Nolven/SAD_glasses/hardware/output/SAD/sad_bom.csv

Manufacturer Part Number | Manufacturer | Description | References | Qty per board | Order Qty
LP5012RUKR | Texas Instruments | 12-ch I2C LED driver WQFN-20 3x3 | IC1 | 1 | 3
ATTINY1616-MNR | Microchip | AVR MCU 16KB VQFN-20 3x3 | U1 | 1 | 3
MCP73831T-2ACI/OT | Microchip | Li-ion charger 4.20V SOT-23-5 | U2 | 1 | 3
TPD1E10B06DPYR | Texas Instruments | ESD TVS 5.5V bidirectional 0402 X1SON (SOD-882 size) | D1, D2 | 2 | 6
EVQ-P7A01P | Panasonic | Side-push tact switch 3.5x2.9mm 2.2N | S1, S2 | 2 | 6
USB4105-GF-A | GCT | USB-C 2.0 16P top-mount receptacle 0.95mm stakes | J1 | 1 | 3
L1C1-CYN1000000000 | Lumileds | LUXEON C Cyan 490-510nm 2x2mm | LED pads | 12 | 15
CL05A105KP5NNNC | Samsung Electro-Mechanics | 1uF 10V X5R 0402 (alt: TDK C1005X5R1A105K050BC) | C1, C5 | 2 | 10
GRM155R71C104KA88D | Murata | 100nF 16V X7R 0402 | C2 | 1 | 10
GRM155R71H103KA88D | Murata | 10nF 50V X7R 0402 | C3, C4 | 2 | 10
CL10A475KO8NNNC | Samsung Electro-Mechanics | 4.7uF 16V X5R 0603 (alt: TDK C1608X5R1C475K080AC) | C6, C7, C8 (+ anode bulk cap) | 4 | 15
RC0402FR-072K94L | Yageo | 2.94k 1% 0402 | R1 | 1 | 10
RC0402FR-07100KL | Yageo | 100k 1% 0402 | R2 | 1 | 10
RC0402FR-076K8L | Yageo | 6.8k 1% 0402 | R3 | 1 | 10
RC0402FR-074K7L | Yageo | 4.7k 1% 0402 | R4, R10, R11 | 3 | 10
RC0402FR-071ML | Yageo | 1M 1% 0402 | R5 | 1 | 10
RC0402FR-075K1L | Yageo | 5.1k 1% 0402 | R6, R7 | 2 | 10
RC0402FR-071KL | Yageo | 1k 1% 0402 | R8, R9, R12 | 3 | 10
