Nolven/SAD_glasses/hardware/LED_platform/LED_platform.kicad_pcb

## KiCad design hardware/LED_platform/LED_platform.kicad_pcb (2026-10-20)

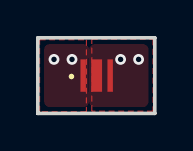
[picture p1: board LED_platform.kicad_pcb from above]

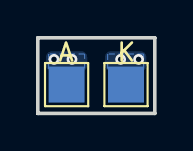
[picture p2: board LED_platform.kicad_pcb from below]

Board: 2 copper layers, 6.5 x 4.2 mm, 3 parts (2 on the bottom side), 2 nets, no tracks yet.

Parts:
A: A; TestPoint_Pad_2.0x2.0mm
K: K; TestPoint_Pad_2.0x2.0mm
LED1: L1C1-CYN1000000000; L1C1CYN1000000000

Connections:
unnamed: A.1 (1_1), LED1.2 (A), LED1.3 (HEAT_PAD)
unnamed: K.1 (1_1), LED1.1 (K)
