Nolven/SAD_glasses/hardware/sad/sad.kicad_pcb

## KiCad design hardware/sad/sad.kicad_pcb (2026-10-15)

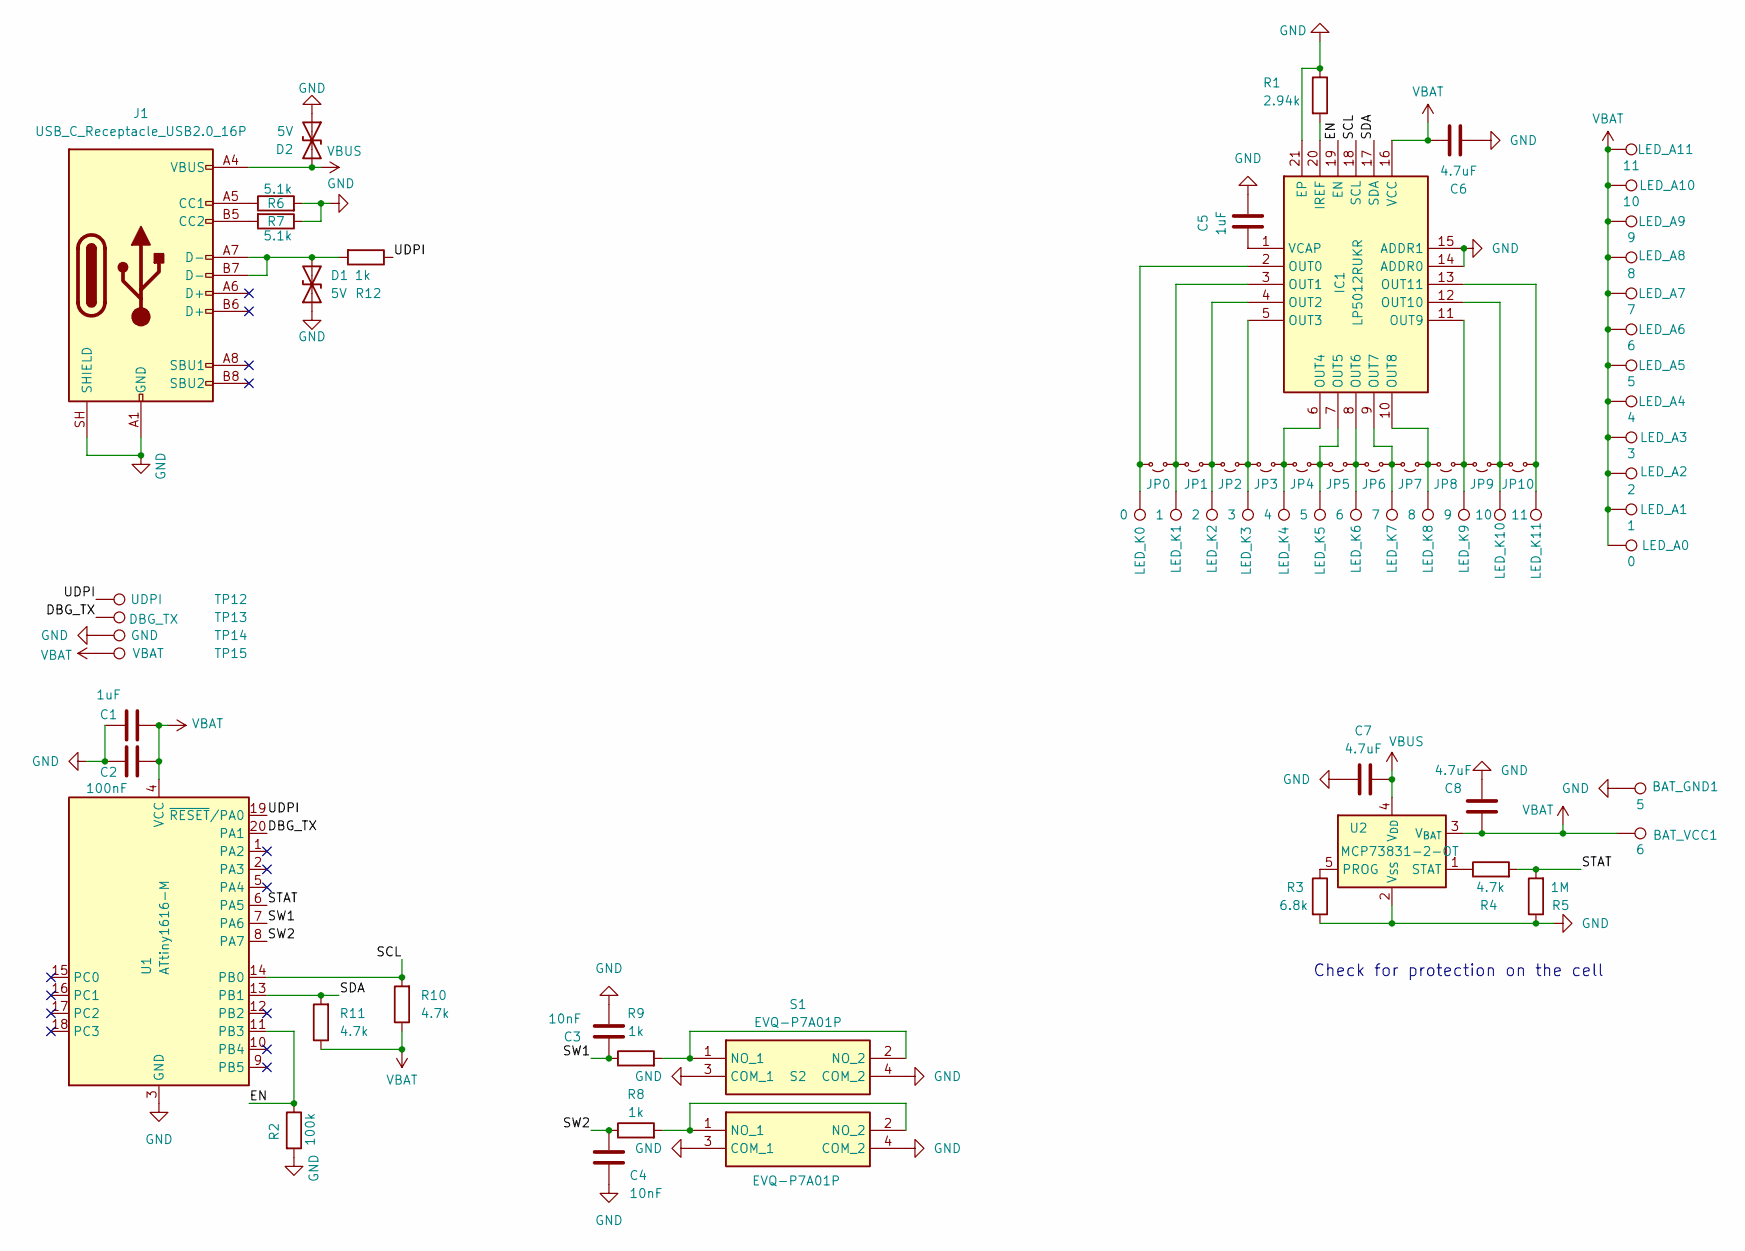
[picture p3: schematic sad.kicad_sch]

Parts:
BAT_GND1: 5; SolderWirePad_1x01_SMD_1x2mm
BAT_VCC1: 6; SolderWirePad_1x01_SMD_1x2mm
C1, C5: 1uF; C_0402_1005Metric_Pad0.74x0.62mm_HandSolder
C2: 100nF; C_0402_1005Metric_Pad0.74x0.62mm_HandSolder
C3, C4: 10nF; C_0402_1005Metric_Pad0.74x0.62mm_HandSolder
C6, C7, C8: 4.7uF; C_0603_1608Metric_Pad1.08x0.95mm_HandSolder
D1, D2: 5V; D_SOD-882
IC1: LP5012RUKR; QFN40P300X300X80-21N-D; Manufacturer_Part_Number LP5012RUKR; Mouser Part Number 595-LP5012RUKR
J1: USB_C_Receptacle_USB2.0_16P; USB_C_Receptacle_GCT_USB4105-xx-A_16P_TopMnt_Horizontal
JP0, JP1, JP2, JP3, JP4, JP5, JP6, JP7, JP8, JP9, JP10: R_0402_1005Metric_Pad0.72x0.64mm_HandSolder
LED_A0: 0; SolderWirePad_1x01_SMD_1x2mm
LED_A1: 1; SolderWirePad_1x01_SMD_1x2mm
LED_A2: 2; SolderWirePad_1x01_SMD_1x2mm
LED_A3: 3; SolderWirePad_1x01_SMD_1x2mm
LED_A4: 4; SolderWirePad_1x01_SMD_1x2mm
LED_A5: 5; SolderWirePad_1x01_SMD_1x2mm
LED_A6: 6; SolderWirePad_1x01_SMD_1x2mm
LED_A7: 7; SolderWirePad_1x01_SMD_1x2mm
LED_A8: 8; SolderWirePad_1x01_SMD_1x2mm
LED_A9: 9; SolderWirePad_1x01_SMD_1x2mm
LED_A10: 10; SolderWirePad_1x01_SMD_1x2mm
LED_A11: 11; SolderWirePad_1x01_SMD_1x2mm
LED_K0: 0; SolderWirePad_1x01_SMD_1x2mm
LED_K1: 1; SolderWirePad_1x01_SMD_1x2mm
LED_K2: 2; SolderWirePad_1x01_SMD_1x2mm
LED_K3: 3; SolderWirePad_1x01_SMD_1x2mm
LED_K4: 4; SolderWirePad_1x01_SMD_1x2mm
LED_K5: 5; SolderWirePad_1x01_SMD_1x2mm
LED_K6: 6; SolderWirePad_1x01_SMD_1x2mm
LED_K7: 7; SolderWirePad_1x01_SMD_1x2mm
LED_K8: 8; SolderWirePad_1x01_SMD_1x2mm
LED_K9: 9; SolderWirePad_1x01_SMD_1x2mm
LED_K10: 10; SolderWirePad_1x01_SMD_1x2mm
LED_K11: 11; SolderWirePad_1x01_SMD_1x2mm
R1: 2.94k; R_0402_1005Metric_Pad0.72x0.64mm_HandSolder
R2: 100k; R_0402_1005Metric_Pad0.72x0.64mm_HandSolder
R3: 6.8k; R_0402_1005Metric_Pad0.72x0.64mm_HandSolder
R4, R10, R11: 4.7k; R_0402_1005Metric_Pad0.72x0.64mm_HandSolder
R5: 1M; R_0402_1005Metric_Pad0.72x0.64mm_HandSolder
R6, R7: 5.1k; R_0402_1005Metric_Pad0.72x0.64mm_HandSolder
R8, R9, R12: 1k; R_0402_1005Metric_Pad0.72x0.64mm_HandSolder
S1, S2: EVQ-P7A01P; EVQP7J01P; Manufacturer_Part_Number EVQ-P7A01P; Mouser Part Number 667-EVQP7A01P
TP12: UDPI; SolderWirePad_1x01_SMD_1x2mm
TP13: DBG_TX; SolderWirePad_1x01_SMD_1x2mm
TP14: GND; SolderWirePad_1x01_SMD_1x2mm
TP15: VBAT; SolderWirePad_1x01_SMD_1x2mm
U1: ATtiny1616-M; VQFN-20-1EP_3x3mm_P0.4mm_EP1.7x1.7mm
U2: MCP73831-2-OT; SOT-23-5

Connections:
/DBG_TX: TP13.1, U1.20 (PA1); also elsewhere on the board
/EN: IC1.19 (EN), R2.1, U1.11 (PB3)
/SCL: IC1.18 (SCL), R10.2, U1.14 (PB0)
/SDA: IC1.17 (SDA), R11.2, U1.13 (PB1)
/STAT: R4.2, R5.2, U1.6 (PA5)
/SW1: C3.1, R9.1, U1.7 (PA6)
/SW2: C4.1, R8.1, U1.8 (PA7)
/UDPI: R12.1, TP12.1, U1.19 (~RESET/PA0); also elsewhere on the board
GND: BAT_GND1.1, C1.2, C2.1, C3.2, C4.2, C5.2, C6.1, C7.1, C8.2, D1.1 (A1), D2.1 (A1), IC1.14 (ADDR0), IC1.15 (ADDR1), IC1.21 (EP), J1.A1 (GND), J1.A12 (GND), J1.B1 (GND), J1.B12 (GND), J1.SH (SHIELD), R1.1, R2.2, R3.2, R5.1, R6.2, R7.1, S1.3 (COM_1), S1.4 (COM_2), S2.3 (COM_1), S2.4 (COM_2), TP14.1, U1.3 (GND), U1.21 (GND), U2.2 (V_{SS}); also elsewhere on the board
unnamed: D1.2 (A2), J1.A7 (D-), J1.B7 (D-), R12.2
unnamed: IC1.20 (IREF), R1.2
unnamed: IC1.2 (OUT0), JP0.2 (B), LED_K0.1 (1_1)
unnamed: IC1.3 (OUT1), JP0.1 (A), JP1.2 (B), LED_K1.1 (1_1)
unnamed: IC1.4 (OUT2), JP1.1 (A), JP2.1 (A), LED_K2.1 (1_1)
unnamed: IC1.5 (OUT3), JP2.2 (B), JP3.2 (B), LED_K3.1 (1_1)
unnamed: IC1.6 (OUT4), JP3.1 (A), JP4.2 (B), LED_K4.1 (1_1)
unnamed: IC1.7 (OUT5), JP4.1 (A), JP5.2 (B), LED_K5.1 (1_1)
unnamed: IC1.8 (OUT6), JP5.1 (A), JP6.2 (B), LED_K6.1 (1_1)
unnamed: IC1.9 (OUT7), JP6.1 (A), JP7.2 (B), LED_K7.1 (1_1)
unnamed: IC1.10 (OUT8), JP7.1 (A), JP8.2 (B), LED_K8.1 (1_1)
unnamed: IC1.11 (OUT9), JP8.1 (A), JP9.2 (B), LED_K9.1 (1_1)
unnamed: IC1.12 (OUT10), JP9.1 (A), JP10.2 (B), LED_K10.1 (1_1)
unnamed: IC1.13 (OUT11), JP10.1 (A), LED_K11.1 (1_1)
unnamed: C5.1, IC1.1 (VCAP)
unnamed: J1.A5 (CC1), R6.1
unnamed: J1.B5 (CC2), R7.2
unnamed: R9.2, S1.1 (NO_1), S1.2 (NO_2)
unnamed: R8.2, S2.1 (NO_1), S2.2 (NO_2)
unnamed: R3.1, U2.5 (PROG)
unnamed: R4.1, U2.1 (STAT)
VBAT: BAT_VCC1.1, C1.1, C2.2, C6.2, C8.1, IC1.16 (VCC), LED_A0.1 (1_1), LED_A1.1 (1_1), LED_A2.1 (1_1), LED_A3.1 (1_1), LED_A4.1 (1_1), LED_A5.1 (1_1), LED_A6.1 (1_1), LED_A7.1 (1_1), LED_A8.1 (1_1), LED_A9.1 (1_1), LED_A10.1 (1_1), LED_A11.1 (1_1), R10.1, R11.1, TP15.1, U1.4 (VCC), U2.3 (V_{BAT}); also elsewhere on the board
VBUS: C7.2, D2.2 (A2), J1.A4 (VBUS), J1.A9 (VBUS), J1.B4 (VBUS), J1.B9 (VBUS), U2.4 (V_{DD})

Notes on the sheet:
Check for protection on the cell

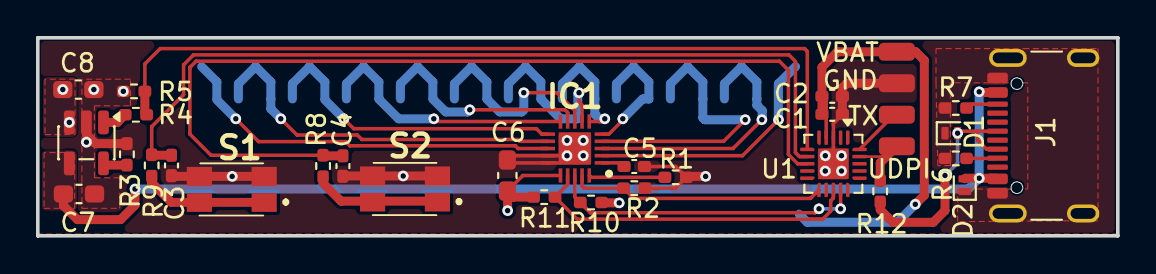
[picture p4: board sad.kicad_pcb from above]

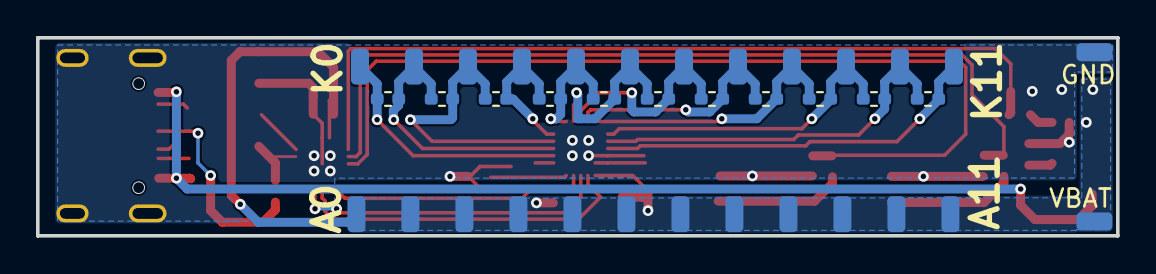
[picture p5: board sad.kicad_pcb from below]

Board: 2 copper layers, 60.0 x 11.0 mm, 69 parts (37 on the bottom side), 32 nets.

Other parts of the board:
GND: GND; SolderWirePad_1x01_SMD_1x2mm
GND#2: 5; SolderWirePad_1x01_SMD_1x2mm
TX: DBG_TX; SolderWirePad_1x01_SMD_1x2mm
UDPI: UDPI; SolderWirePad_1x01_SMD_1x2mm
VBAT: VBAT; SolderWirePad_1x01_SMD_1x2mm
VBAT#2: 6; SolderWirePad_1x01_SMD_1x2mm

Their connections:
/DBG_TX: TX.1 (1_1); also elsewhere on the board
/UDPI: UDPI.1 (1_1); also elsewhere on the board
GND: GND.1 (1_1), GND#2.1 (1_1); also elsewhere on the board
VBAT: VBAT.1 (1_1), VBAT#2.1 (1_1); also elsewhere on the board
