Nolven/SAD_glasses/(commit log)

2026-10-06 init sch finished
    [sad.kicad_sch]
2026-10-08 half footprints added
    [sad.kicad_sch]
2026-10-11 switches updated; basic pcb
2026-10-11 switches updated; border
2026-10-15 footprint fixes
